Space-Fernie/system_test_board/README.md

# system_test_board
Test board for the Arietta G25 system
