Space-Fernie/system_test_board/Battery bracket/assembly.SLDASM

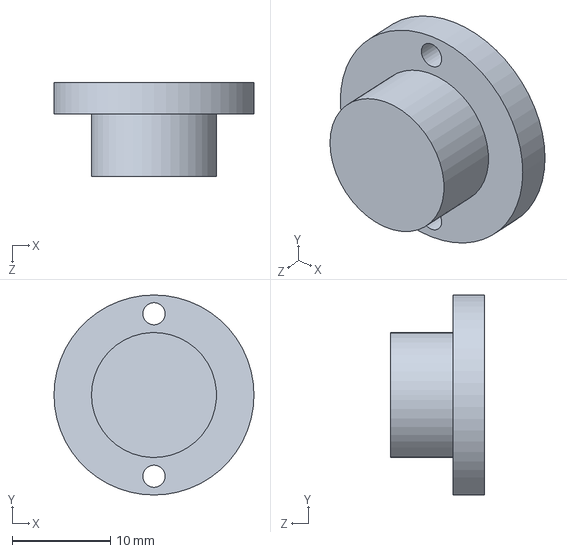
[picture p1: CAD file, 2017-11-16]
Battery bracket/assembly.SLDASM
20.3 x 20.3 x 9.53 mm
