Space-Fernie/system_test_board/Battery bracket/gen2/bracket_half_bottom.SLDPRT

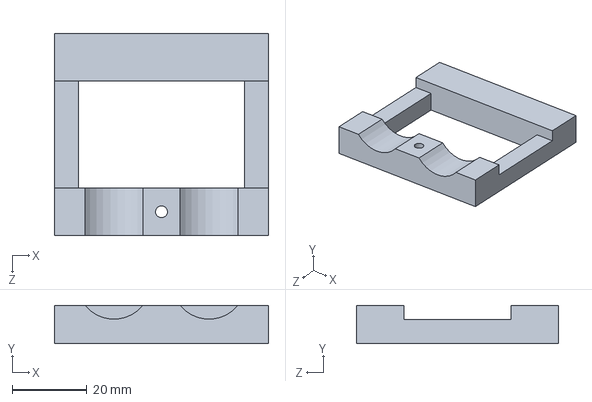
[picture p2: CAD file, 2017-09-18]
Battery bracket/gen2/bracket_half_bottom.SLDPRT
57.1 x 10.2 x 54.0 mm
