Space-Fernie/system_test_board/Test_board/Test_board.FCStd

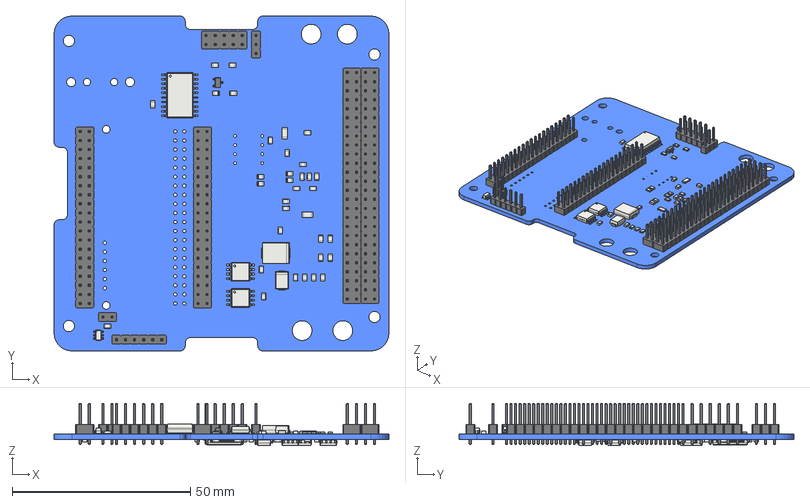
[picture p3: CAD file, 2017-12-14]
Test_board/Test_board.FCStd
94.0 x 94.0 x 11.9 mm
Pcb
Pin_Header_Straight_2x26_Pitch254mm_
Pin_Header_Straight_2x26_Pitch254mm_001
C_0805_
C_0805_001
C_0805_002
C_0805_003
C_0805_004
C_0805_005
C_0805_006
C_0805_007
C_0805_008
C_0805_009
C_0805_010
C_0805_011
C_0805_012
C_0805_013
C_0805_014
C_0805_015
C_0805_016
C_0805_017
C_0805_018
C_0805_019
C_0805_020
C_0805_021
C_0805_022
D_SMB_
D_SMC_
Pin_Header_Straight_2x05_Pitch254mm_
Pin_Header_Straight_1x03_Pitch254mm_
Pin_Header_Straight_2x20_Pitch254mm_
Pin_Header_Straight_1x06_Pitch254mm_
Pin_Header_Straight_2x20_Pitch254mm_001
Pin_Header_Straight_1x02_Pitch254mm_
SOT_23_
R_0805_
R_0805_001
R_0805_002
R_0805_003
R_0805_004
R_0805_005
R_0805_006
R_1206_
R_1206_001
R_0805_007
R_0805_008
R_0805_009
R_0805_010
R_0805_011
R_0805_012
R_0805_013
R_0805_014
R_0805_015
R_1206_002
R_0805_016
R_0805_017
SOIC-20W_7.5x12.8mm_Pitch1.27mm_
SOIJ-8_5.3x5.3mm_Pitch1.27mm_
SOIJ-8_5.3x5.3mm_Pitch1.27mm_001
LQFP-64_10x10mm_Pitch0.5mm_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
