Space-Fernie/system_test_board/Battery bracket/cell.SLDPRT

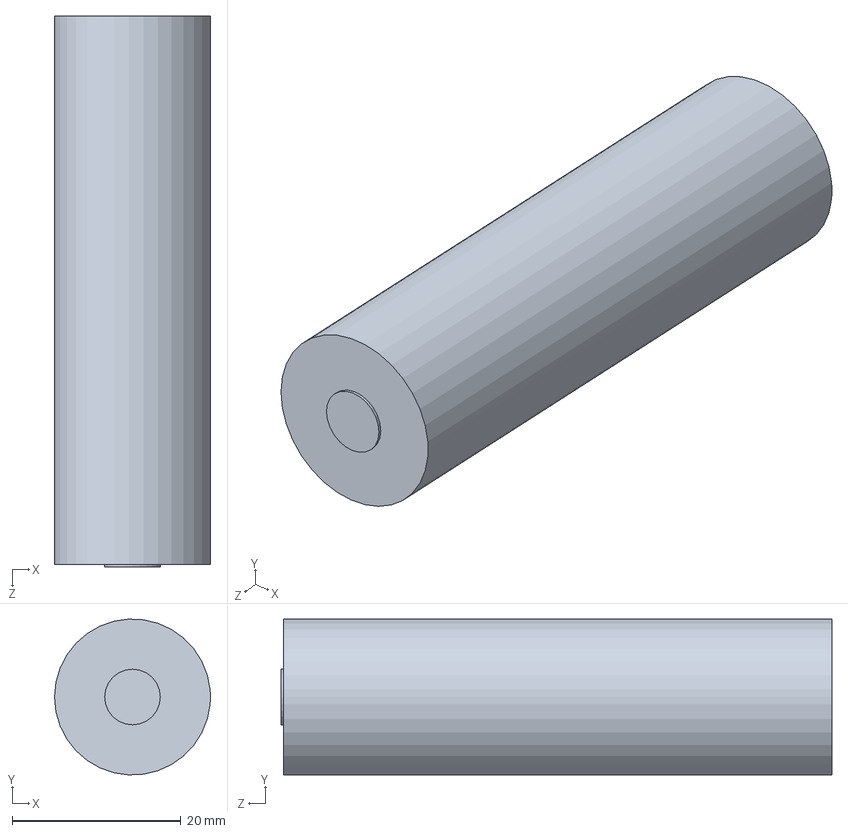
[picture p4: CAD file, 2017-09-18]
Battery bracket/cell.SLDPRT
18.5 x 18.5 x 65.3 mm
