Space-Fernie/system_test_board/Battery bracket/gen1/bracket.SLDASM

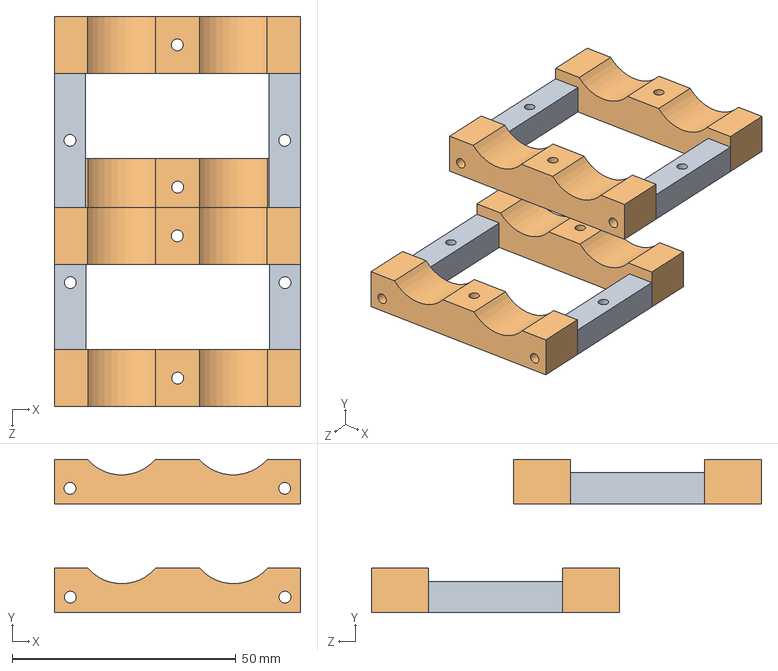
[picture p5: CAD file, 2017-09-18, an earlier design]
Battery bracket/gen1/bracket.SLDASM
55.1 x 34.3 x 87.2 mm
truss x 4
clamp x 4
