Space-Fernie/system_test_board/Battery bracket/gen1/bracket_half_top.SLDASM

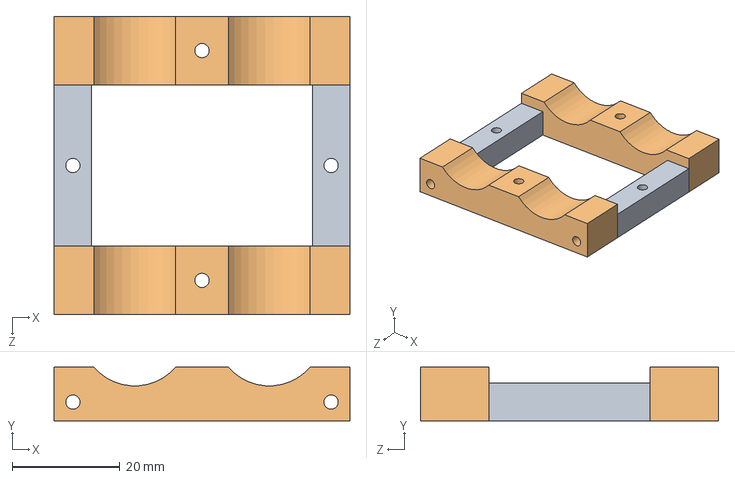
[picture p6: CAD file, 2017-09-18, an earlier design]
Battery bracket/gen1/bracket_half_top.SLDASM
55.0 x 10.0 x 55.4 mm
truss x 2
clamp x 2
