Space-Fernie/system_test_board/Battery bracket/gen1/clamp.SLDPRT

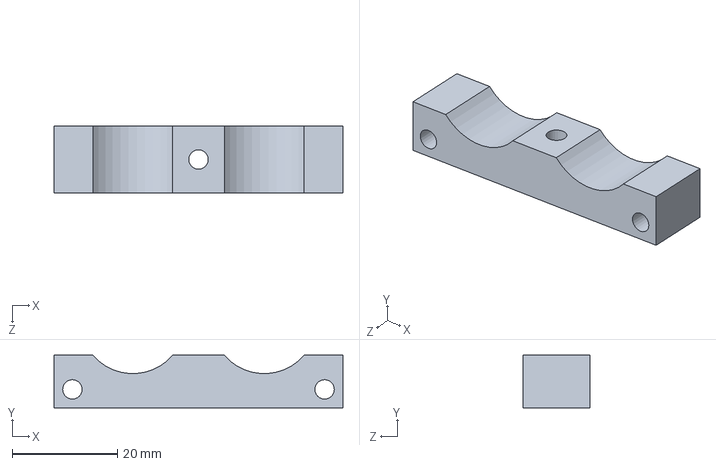
[picture p8: CAD file, 2017-09-18, an earlier design]
Battery bracket/gen1/clamp.SLDPRT
55.0 x 10.0 x 12.7 mm
