Space-Fernie/system_test_board/Battery bracket/gen1/truss.SLDPRT

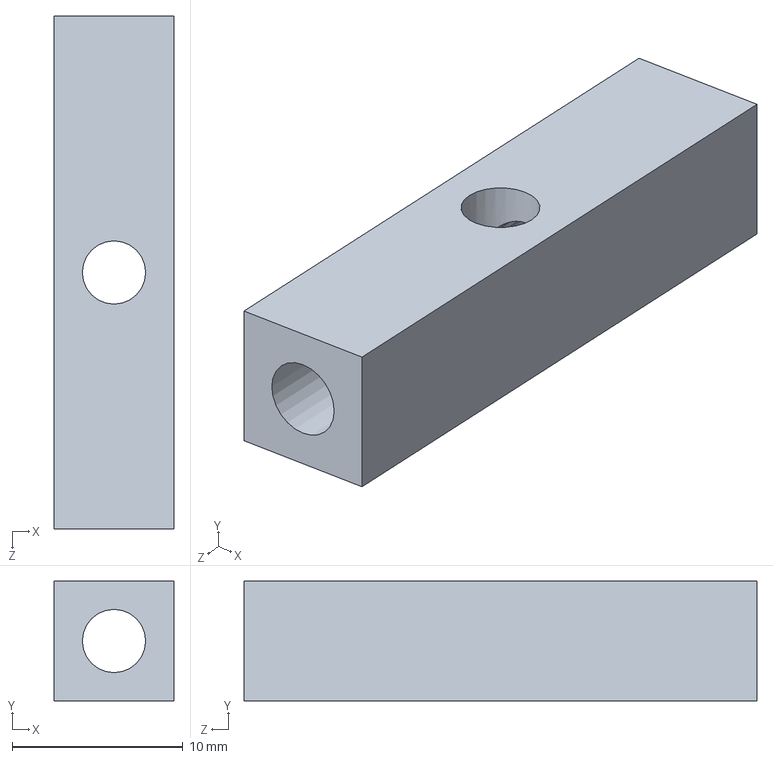
[picture p9: CAD file, 2017-09-18, an earlier design]
Battery bracket/gen1/truss.SLDPRT
7.00 x 7.00 x 30.0 mm
