Space-Fernie/system_test_board/Battery bracket/gen1/3dprintmodel.STL

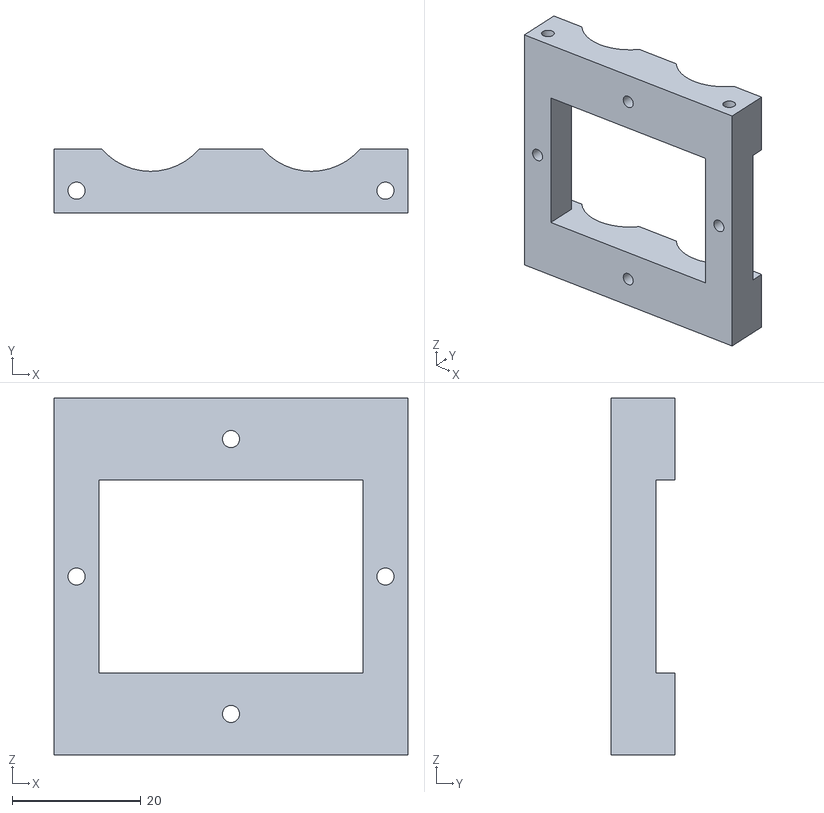
[picture p10: CAD file, 2017-09-18, an earlier design]
Battery bracket/gen1/3dprintmodel.STL
55.0 x 10.0 x 55.4
