Space-Fernie/system_test_board/(list of files, cad)

Other CAD files:
Barometer chamber/test_board model.SLDPRT
Barometer chamber/Barometer chamber.SLDPRT
Test_board/test_board model.wrl.sldprt
Barometer chamber/Barometer chamber.SLDDRW
