Space-Fernie/system_test_board/Documentation/Test Board Spreadsheets.xlsx

Sheet: I2C Addresses
Address | Device | Designator | All available addresses
1110110 | BMP280 |  | 1110110, 1110111
1110111 | BMP280 |  | 1110110, 1110111
1001000 | DS1624 |  | 1001000, 1001001, 1001010, 1001011, 1001100, 1001101, 1001110, 1001111
1001001 | DS1624 |  | 1001000, 1001001, 1001010, 1001011, 1001100, 1001101, 1001110, 1001111
1000000 | INA219 |  | INA219 Sheet
1000001 | INA219 |  | INA219 Sheet
1000100 | INA219 |  | INA219 Sheet
1000101 | INA219 |  | INA219 Sheet
1101000 | DS3232 |  | 1101000

Sheet: INA219 Sheet
A1 | A0 | ADDRESS |  | Rshunt CALCULATIONS AND IC PROGRAMMING
GND | GND | 1000000 | https://docs.google.com/a/spaceconcordia.ca/spreadsheets/d/1U1xCq4XOht2BvLV0Nj3WVBj3vr-w16HBE9G5WGe6P6k/edit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 | <- Power Budget
GND | VS+ | 1000001 | Components |  | Current | Max Vshunt: | 0.05
GND | SDA | 1000010 | Battery Heaters (4) |  | 0.5862 | Rshunt | 0.02319
GND | SCL | 1000011 | Thermistors |  | 0.001
VS+ | GND | 1000100 | OBC |  | 0.0634
VS+ | VS+ | 1000101 | Power Sensors (4) |  | 0.0028 | Total Cal: | 26843 | =0x68DB
VS+ | SDA | 1000110 | RTC |  | 0.0002 | 3V3 Cal: | 48240 | =0xBC70
VS+ | SCL | 1000111 | Pressure Sensors(2) |  | 5.4e-06
SDA | GND | 1001000 | Temp Sensors (2) |  | 0.0025
SDA | VS+ | 1001001 | Comparator |  | 0.0004
SDA | SDA | 1001010 | USB2 Max Current (3) |  | 1.5
SDA | SCL | 1001011 |  | Total Current: | 2.1565054
SCL | GND | 1001100 |  | Power Current_LSB | 6.581132202e-05
SCL | VS+ | 1001101
SCL | SDA | 1001110 |  | 3V3 Max I: | 1.2
SCL | SCL | 1001111 |  | 3V3 Current_LSB | 3.662109375e-05
