Space-Fernie/system_test_board/(threads)

Thread 1 (2017-09-18):

No mounting holes

SpaceFernie, 2017-09-18:
There are no mounting holes on the board. Add some.

SpaceFernie, 2017-11-03:
Fixed with the implementation of a cubesat pcb template

Closed 2017-11-03.

Thread 2 (2017-09-18):

Not enough power vias

SpaceFernie, 2017-09-18:
There is only one via leading from the 3V3 power sensor shunt resistor to the 3V3 plane (the entrance of the 3V3 converter to the power plane). There needs to be more stitching for the line.

SpaceFernie, 2017-11-03:
Complete board redesign, closing issue

Closed 2017-11-03.

Thread 3 (2017-09-18):

Charge pump

SpaceFernie, 2017-09-18:
The board needs a charge pump to improve operation in an irradiated environment.

SpaceFernie, 2017-11-03:
Not sure if charge pump is the good term

SpaceFernie, 2017-11-03:
Will not be implemented. Issue closed

Closed 2017-11-03.

Thread 5 (2017-09-19):

Packages

SpaceFernie, 2017-09-19:
QFN is a terrible package to use when not necessary, simply because it is a pain to assemble a board with. Try to replace all the QFN packages with something like QFP.
Also, try to get larger ICs in general.

SpaceFernie, 2017-11-10:
No QFNs on V2.1

Closed 2017-11-10.

Thread 6 (2017-09-19):

Banana jacks don't fit in hole

SpaceFernie, 2017-09-19:
The banana jacks cannot fit in their holes. The holes are slightly too small. Increase diameter of holes by 0.8 mm.

SpaceFernie, 2017-11-10:
Fixed hole dimension

Closed 2017-11-10.

Thread 8 (2017-09-20):

Replace MCUs

Space-Fernie, 2017-09-20:
Remove PIC24. NASA experiments show that they are not re programmable after enough radiation. Arm will remain, but research should be conducted to determine the best core and manufacturer.

Space-Fernie, 2017-10-09:
Both MCUs removed, STM32F303RE added.

Closed 2017-10-09.

Thread 11 (2017-09-22):

Add ACDS Sensors

SpaceFernie, 2017-09-22:
Add a magnetometer and gyro, and potentially a 9DoF unit. Look into proper installation of units.

SpaceFernie, 2017-11-03:
Will not implement

Closed 2017-11-03.

Thread 12 (2017-09-22):

Add input protection

SpaceFernie, 2017-09-22:
Input protection on banana jacks and battery so that idiots don't destroy everything by applying reverse polarity.

SpaceFernie, 2017-11-07:
Won't be implemented, not enough time.

Closed 2017-11-07.

Thread 9 (2017-09-22):

Capacitors Blocking Battery Bracket

SpaceFernie, 2017-09-22:
Capacitors C30 to C33 are in the way.

SpaceFernie, 2017-11-03:
No batteries to be included on main board in new version

Closed 2017-11-03.

Thread 15 (2017-11-03):

Power bus stability

SpaceFernie, 2017-11-03:
Check rippling on bus, add smoothing of necessary

SpaceFernie, 2017-11-07:
Used manufacturer design

Closed 2017-11-07.
