Space-Fernie/system_test_board/test_board.pdf

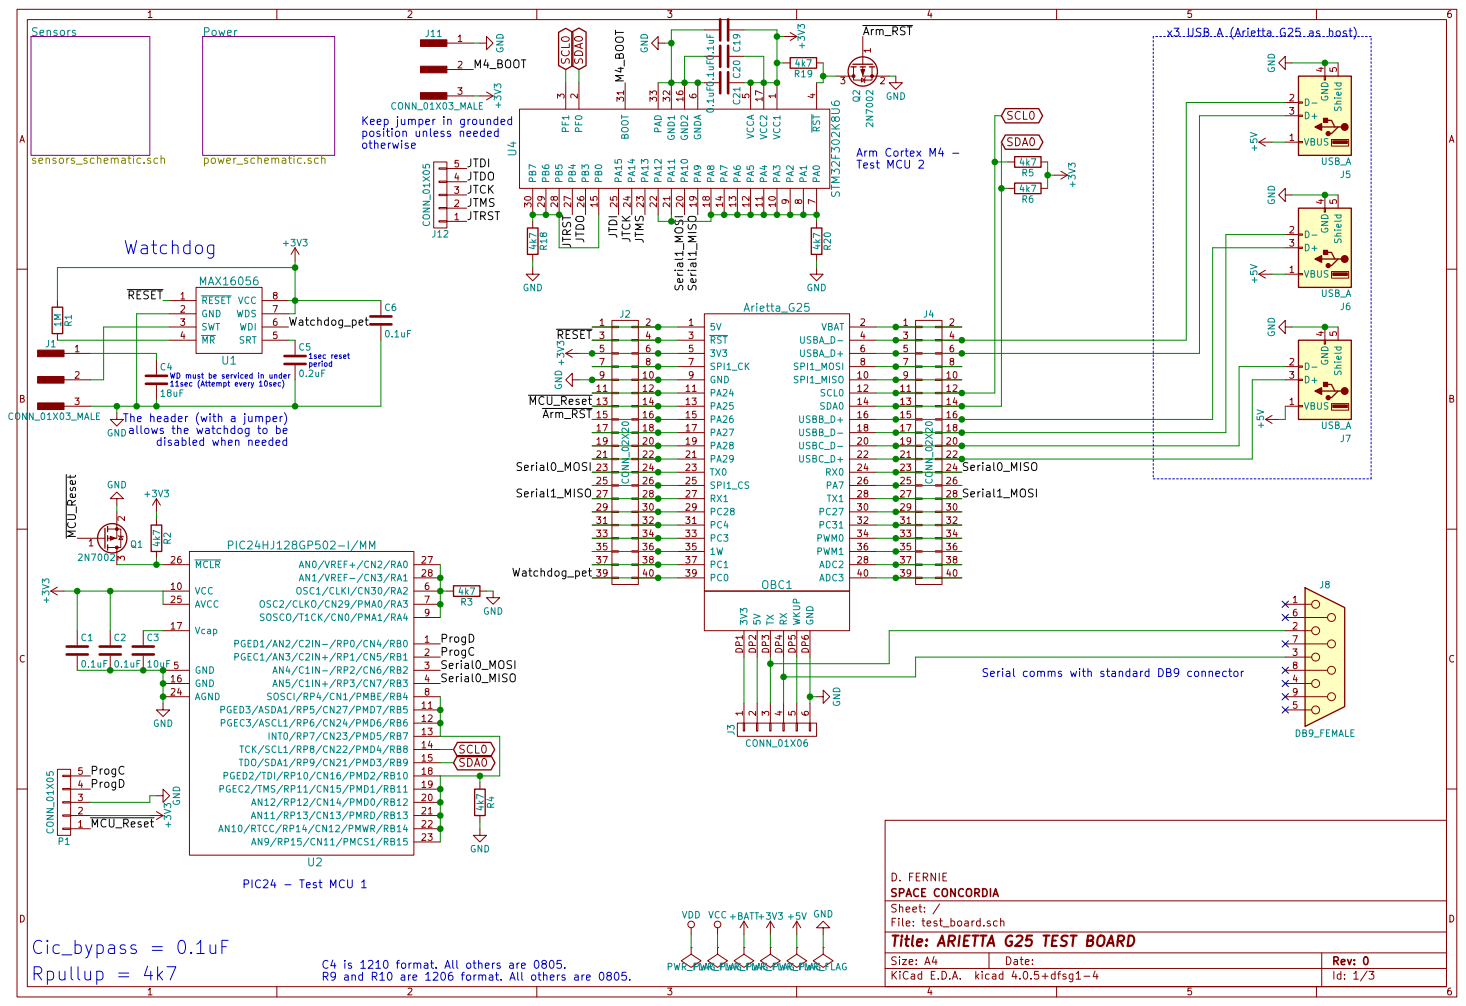
[picture p11: page 1]

x3 USB A (Arietta G25 as host)

Keep jumper in grounded
position unless needed otherwise

The header (with a jumper)
allows the watchdog to be
disabled when needed

Serial comms with standard DB9 connector

D. FERNIE
File: test_board.sch Sheet: / SPACE CONCORDIA

Id: 1/3 Title: ARIETTA G25 TEST BOARD

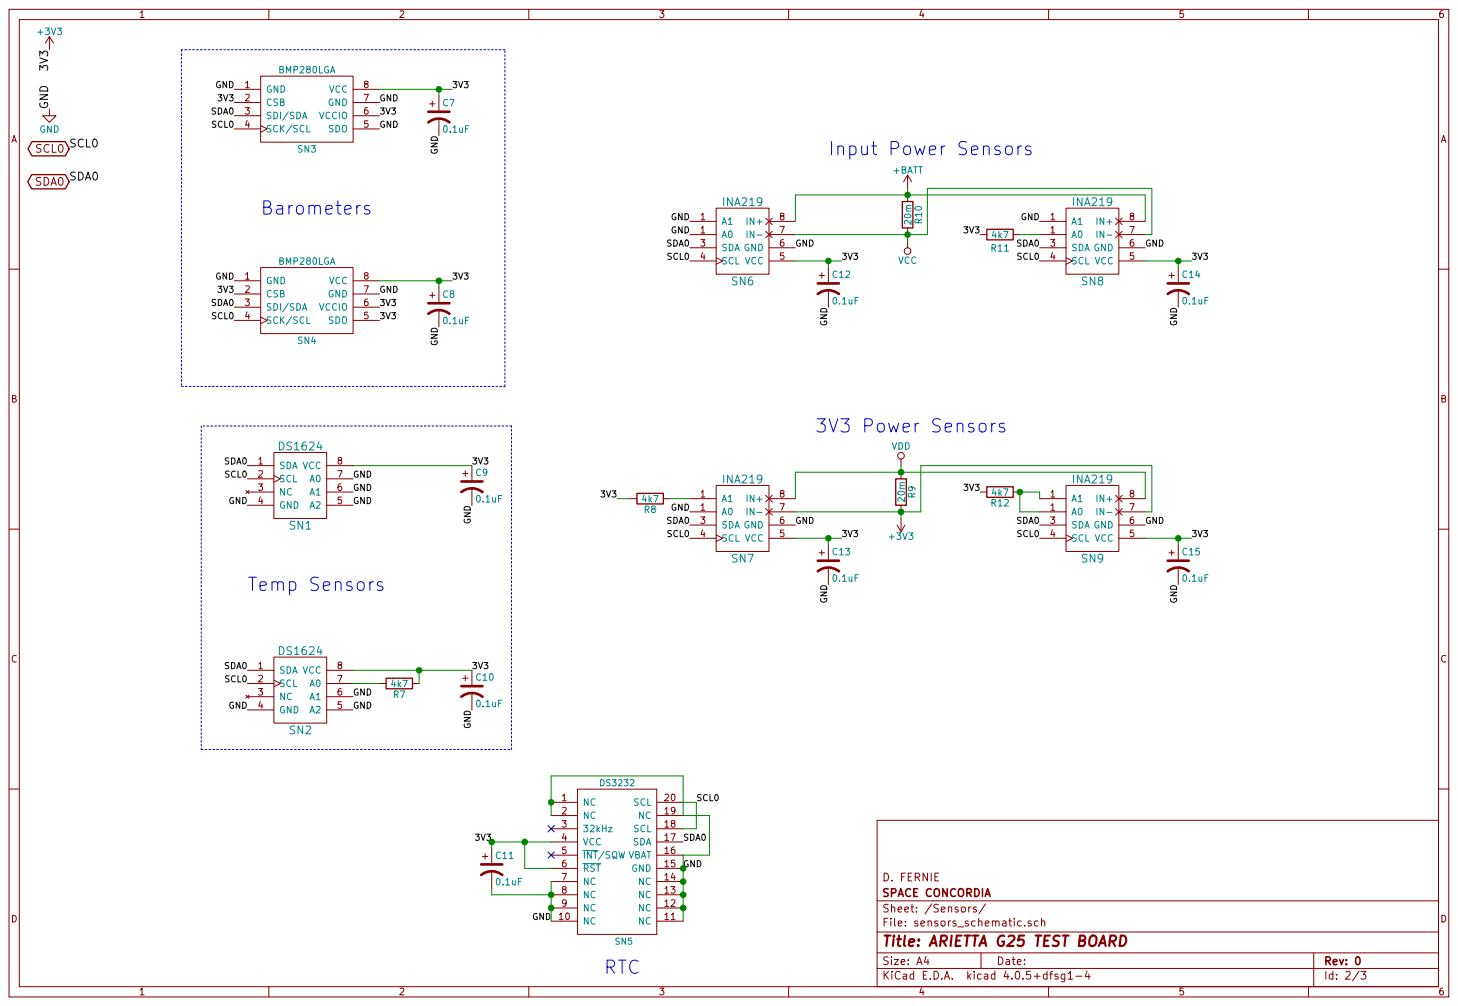
[picture p12: page 2]

D. FERNIE
File: sensors_schematic.sch Sheet: /Sensors/ SPACE CONCORDIA

Id: 2/3 Title: ARIETTA G25 TEST BOARD

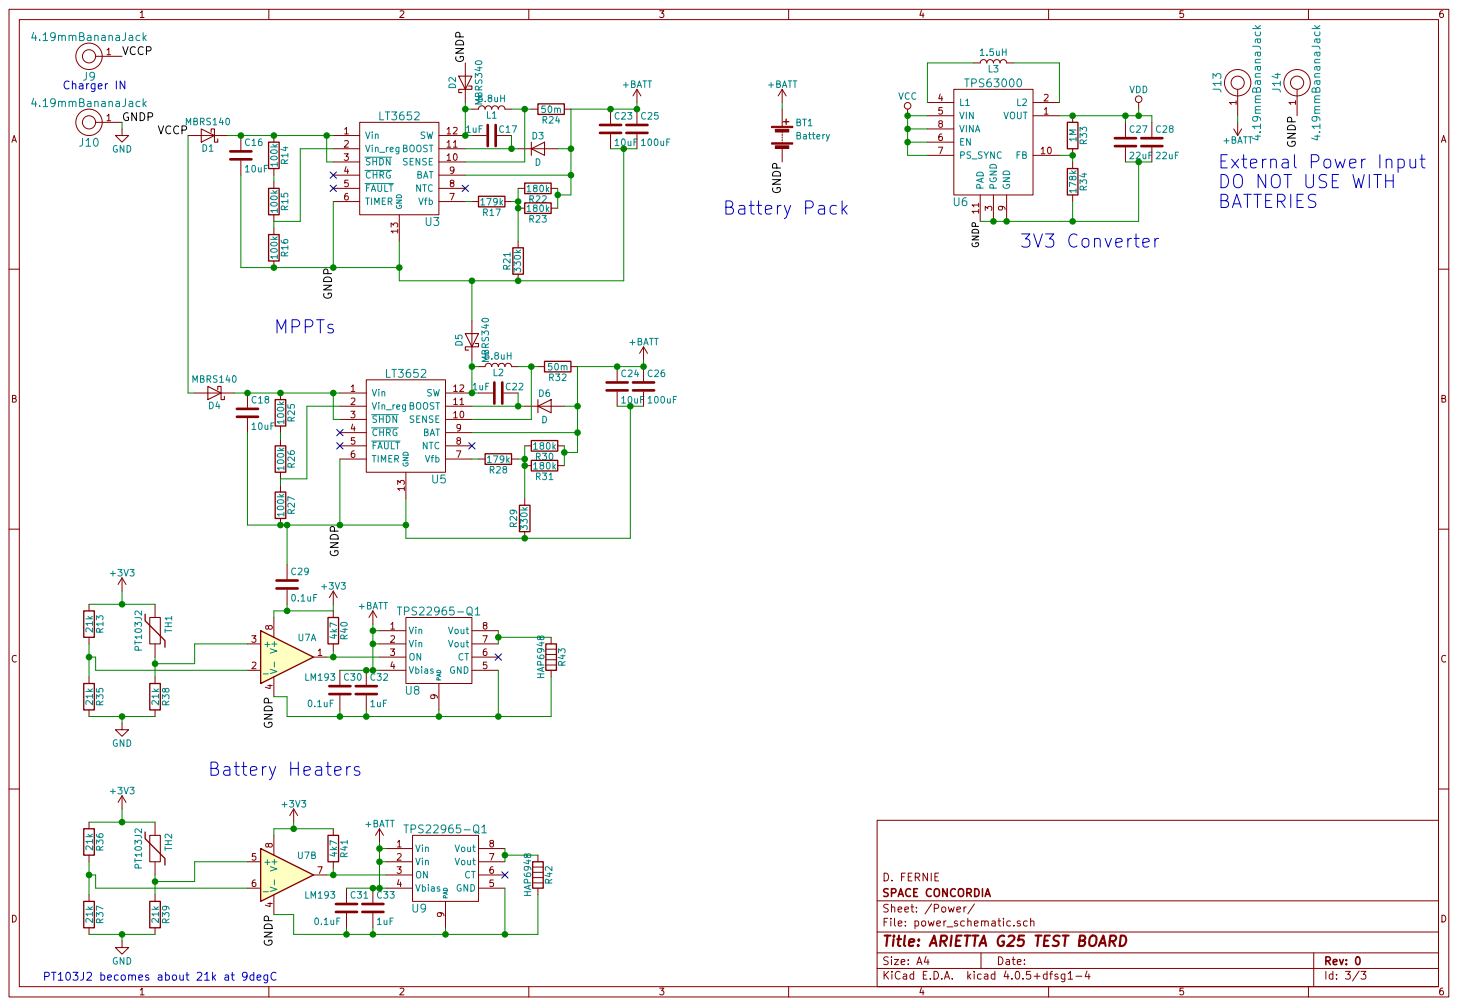
[picture p13: page 3]

External Power Input
DO NOT USE WITH

D. FERNIE
File: power_schematic.sch Sheet: /Power/ SPACE CONCORDIA

Id: 3/3 Title: ARIETTA G25 TEST BOARD
