Space-Fernie/system_test_board/Documentation/arietta_footprint.pdf

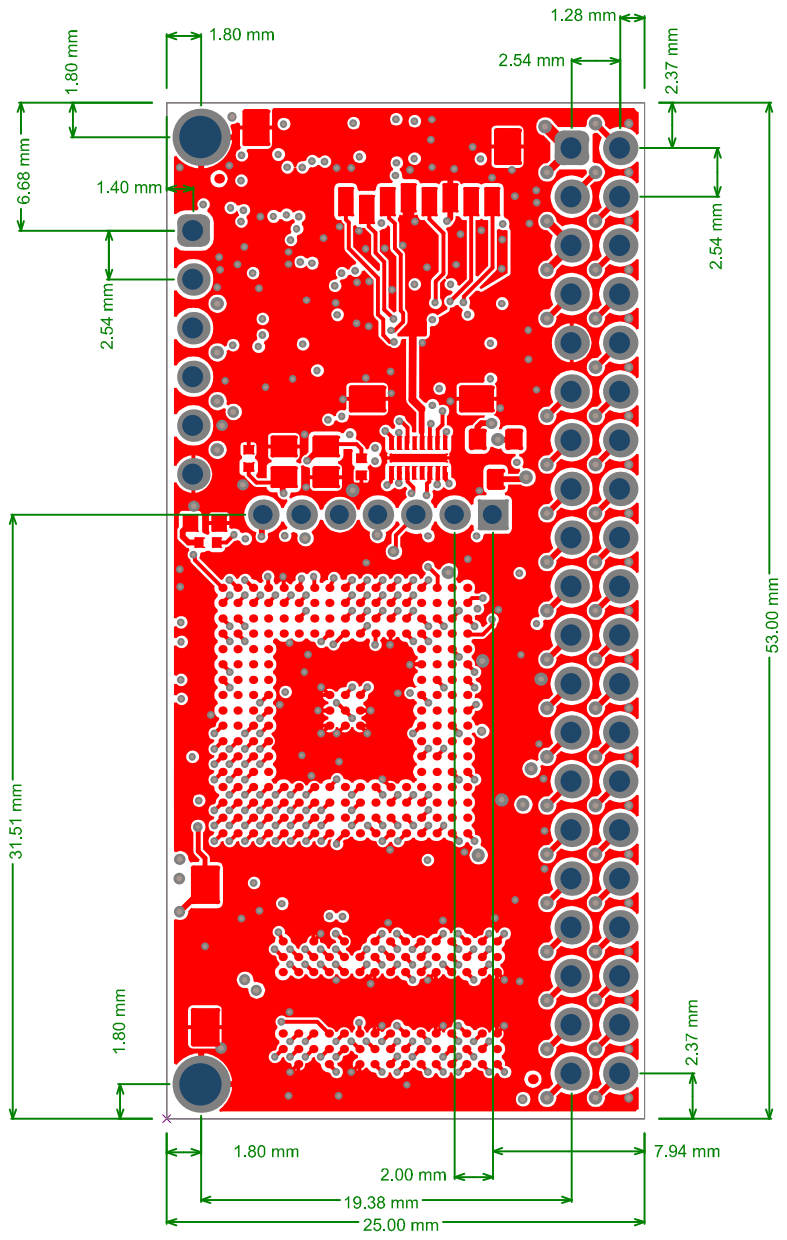
[picture p14: page 1]
