Space-Fernie/system_test_board/Battery bracket/gen1/old battery bracket.PDF

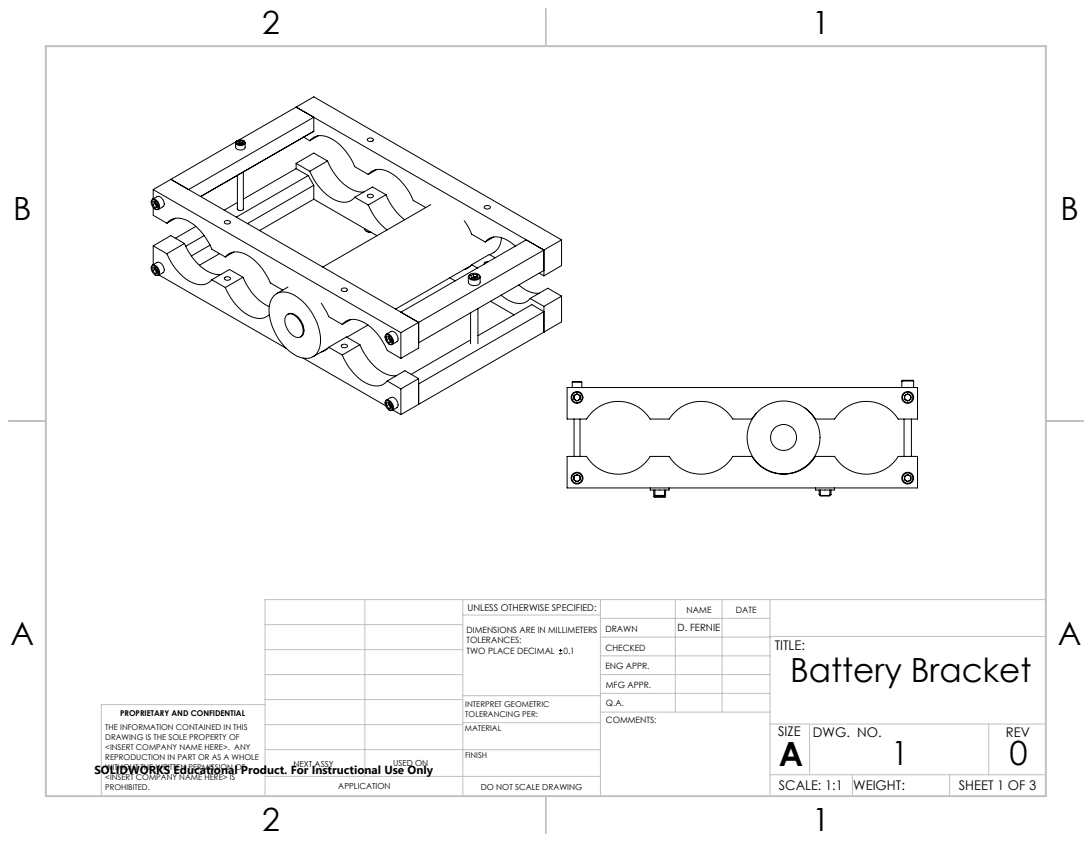
[picture p15: page 1]
SHEET 1 OF 3; SCALE: 1:1; WEIGHT:; DWG. NO.; REV; NEXT ASSY; USED ON

UNLESS OTHERWISE SPECIFIED: | | NAME | DATE
DIMENSIONS ARE IN MILLIMETERS TOLERANCES: TWO PLACE DECIMAL 0.1 | DRAWN | D. FERNIE

CHECKED | | | TITLE: Battery Bracket

ENG APPR.
MFG APPR.

INTERPRET GEOMETRIC TOLERANCING PER: | Q.A.

PROPRIETARY AND CONFIDENTIAL
THE INFORMATION CONTAINED IN THIS
DRAWING IS THE SOLE PROPERTY OF
<INSERT COMPANY NAME HERE>. ANY
REPRODUCTION IN PART OR AS A WHOLE
SOLIDWORKS Educational Product. For Instructional Use Only
WITHOUT THE WRITTEN PERMISSION OF
<INSERT COMPANY NAME HERE> IS
PROHIBITED.

DO NOT SCALE DRAWING

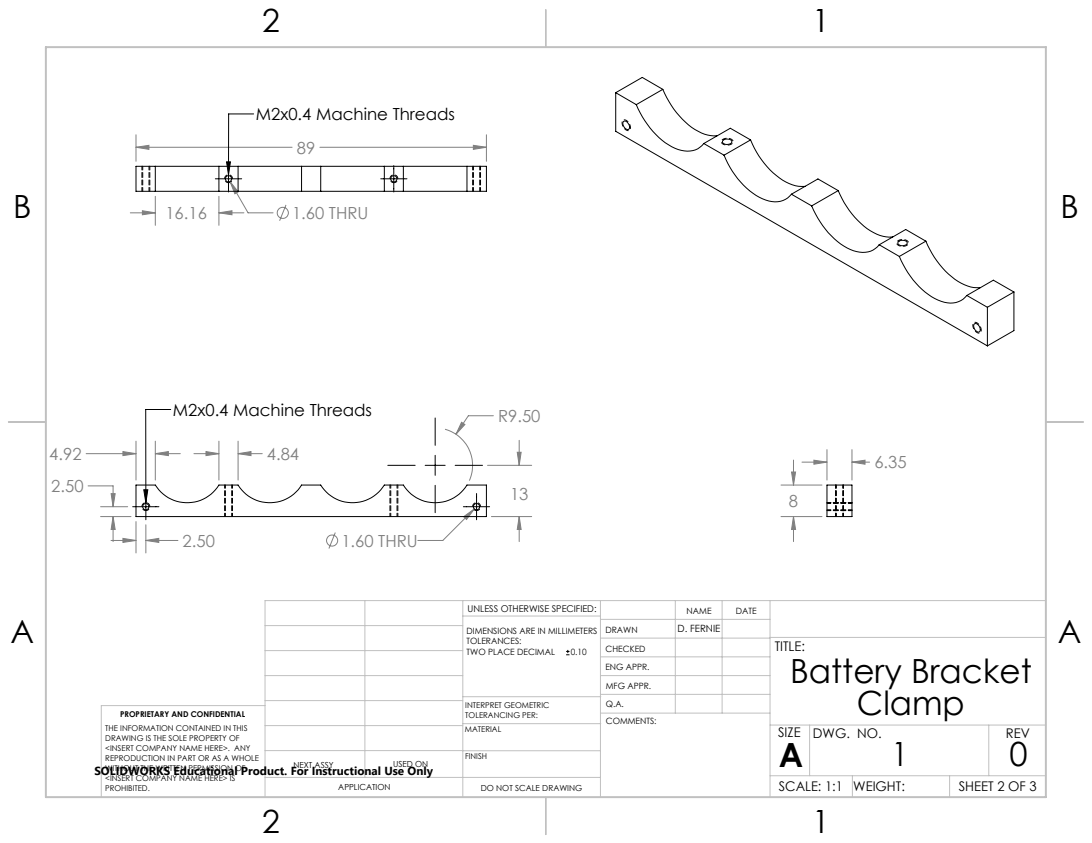
[picture p16: page 2]
1.60 THRU; M2x0.4 Machine Threads; SCALE: 1:1; WEIGHT:; DWG. NO.; REV; NEXT ASSY; USED ON

UNLESS OTHERWISE SPECIFIED: | | NAME | DATE
DIMENSIONS ARE IN MILLIMETERS TOLERANCES: TWO PLACE DECIMAL 0.10 | DRAWN | D. FERNIE

CHECKED | | | TITLE: Battery Bracket Clamp

ENG APPR.
MFG APPR.

INTERPRET GEOMETRIC TOLERANCING PER: | Q.A.

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

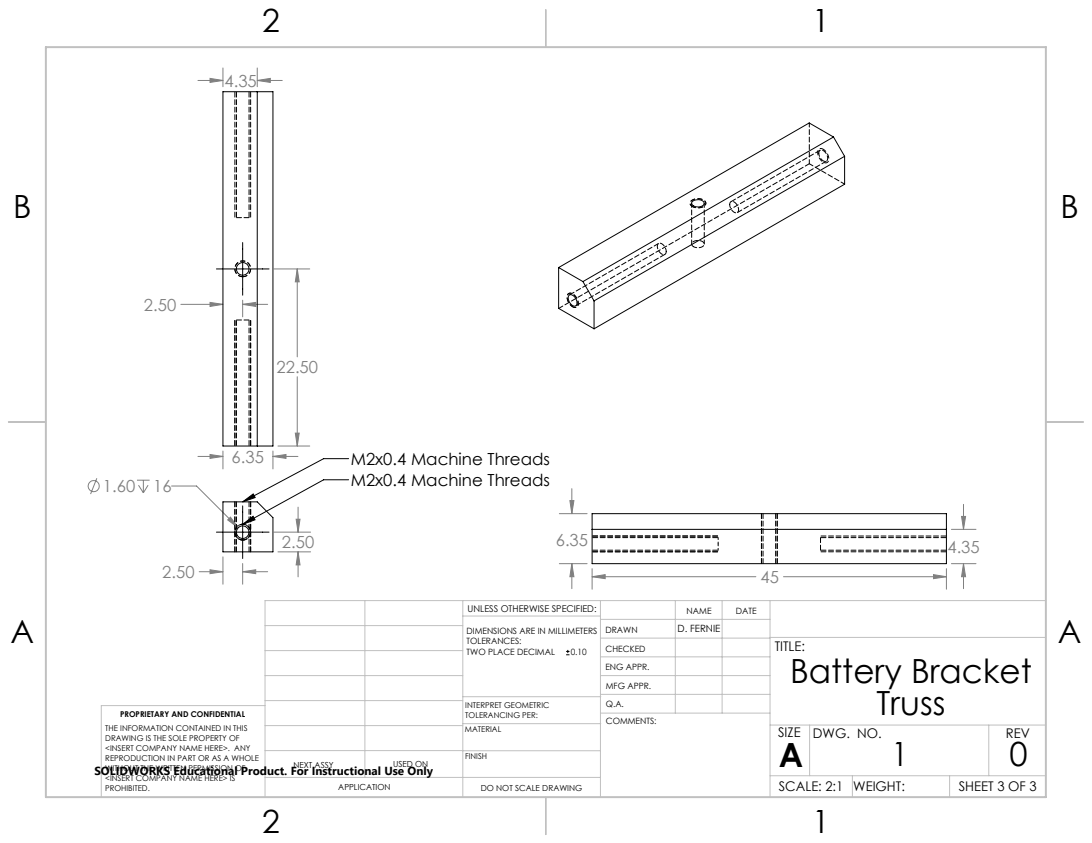
[picture p17: page 3]
M2x0.4 Machine Threads M2x0.4 Machine Threads; SCALE: 2:1; WEIGHT:; DWG. NO.; REV; NEXT ASSY; USED ON

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

CHECKED | | | TITLE: Battery Bracket Truss

ENG APPR.
MFG APPR.

INTERPRET GEOMETRIC TOLERANCING PER: | Q.A.

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
