Space-Fernie/system_test_board/Test_board/Test_board.kicad_pcb

## KiCad design Test_board/Test_board.kicad_pcb (2017-11-10)

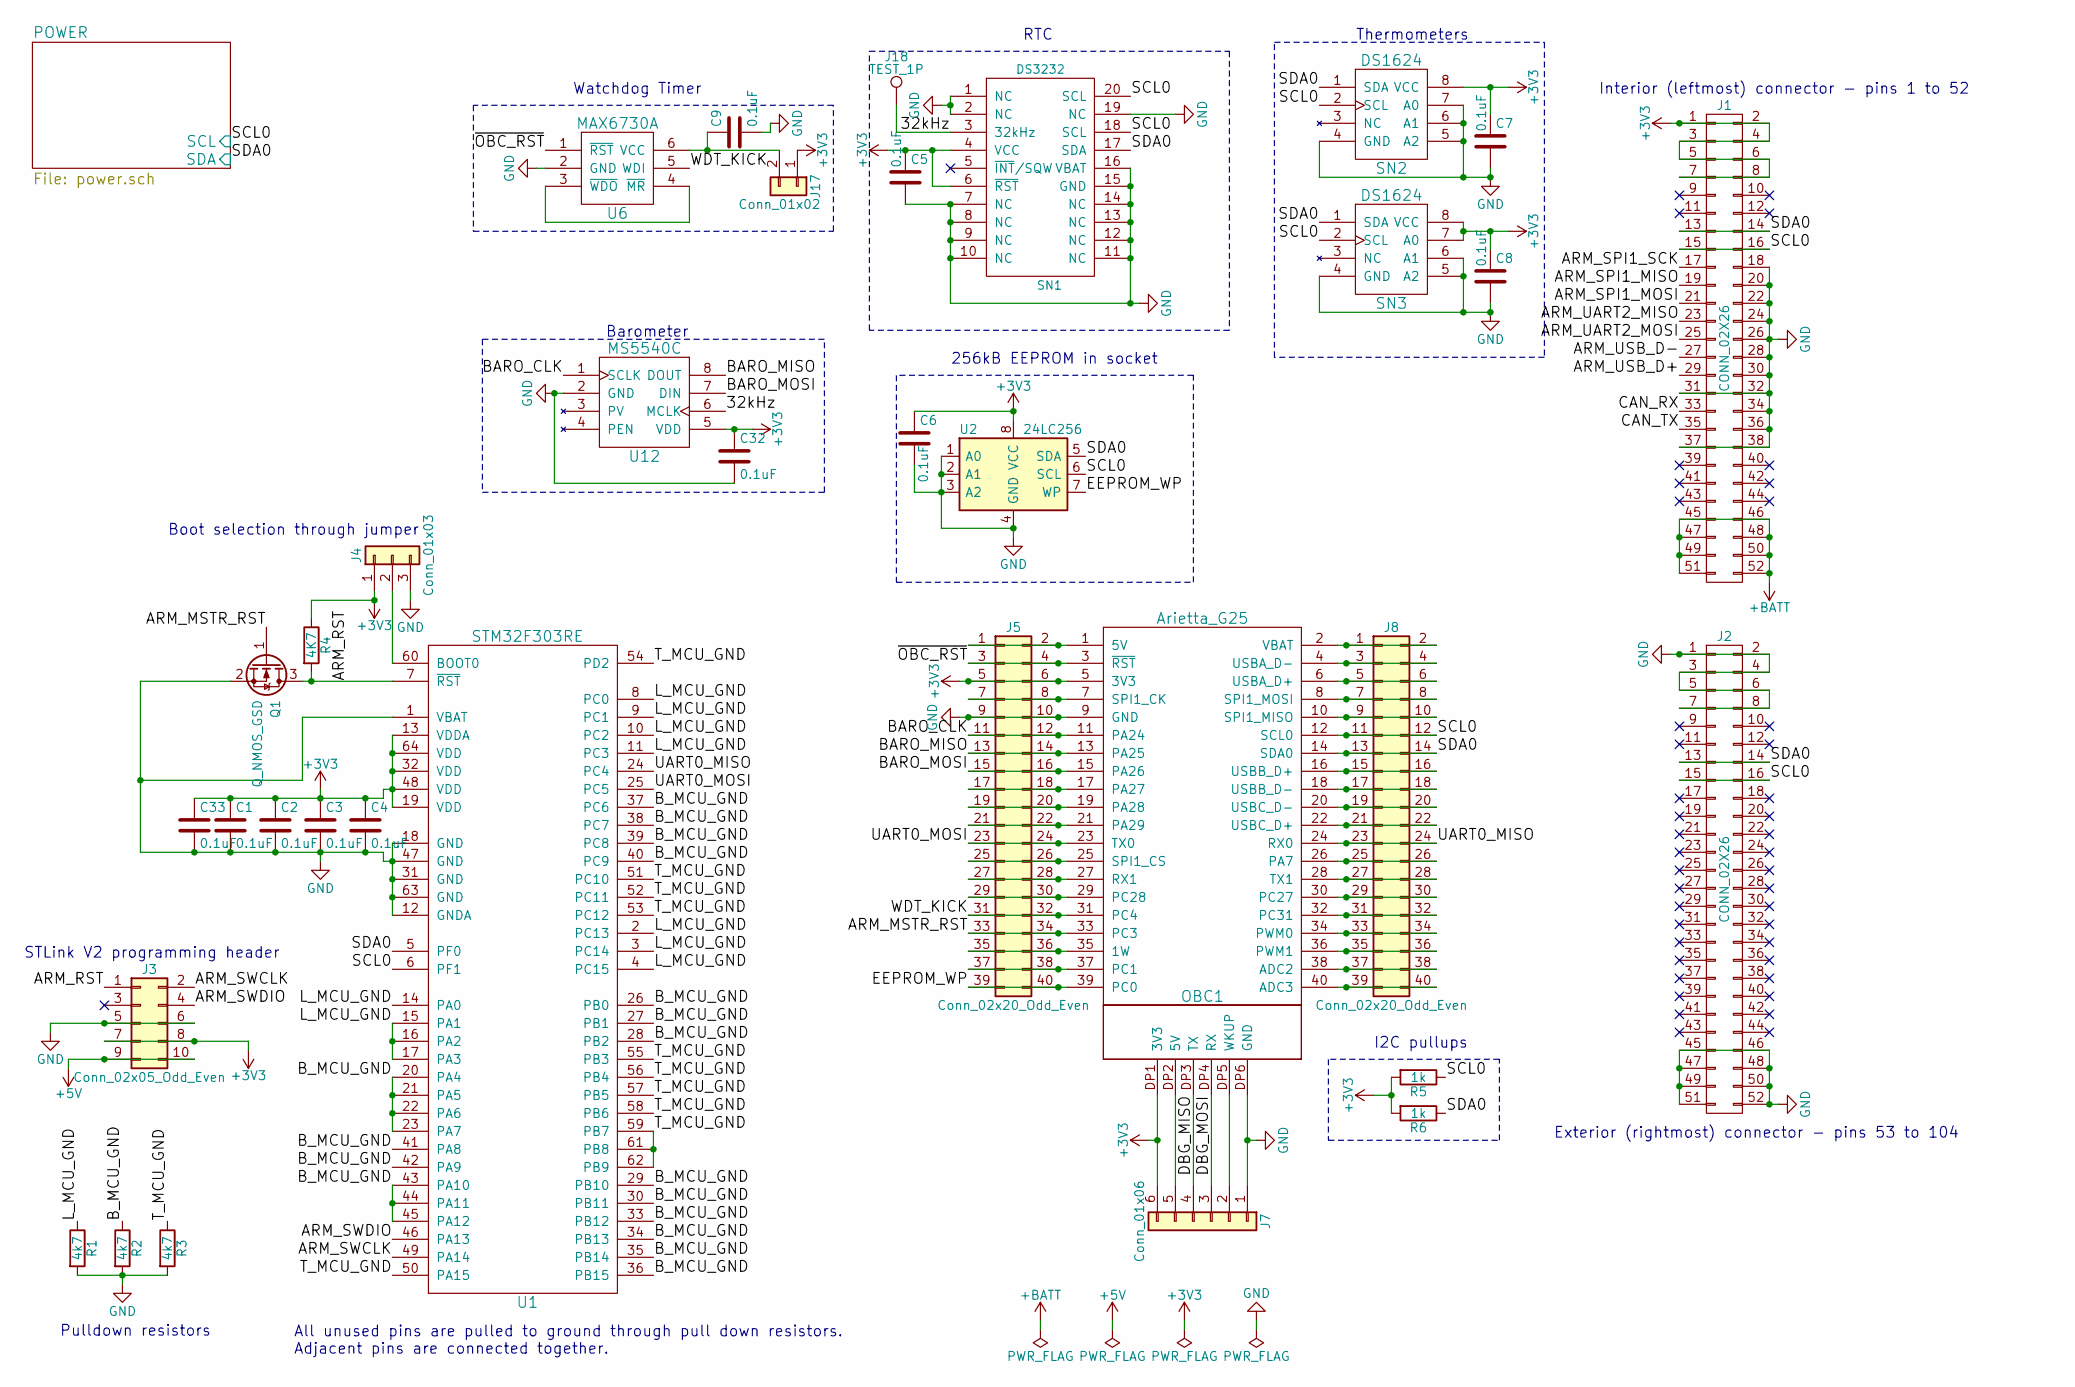
[picture p18: schematic test_board.sch, ARIETTA TEST BOARD]

Parts:
C1, C2, C3, C4, C5, C6, C7, C8, C9, C32, C33: 0.1uF; C_0805_HandSoldering
J1, J2: CONN_02X26; Pin_Header_Straight_2x26_Pitch2.54mm
J3: Conn_02x05_Odd_Even; Pin_Header_Straight_2x05_Pitch2.54mm
J4: Conn_01x03; Pin_Header_Straight_1x03_Pitch2.54mm
J5, J8: Conn_02x20_Odd_Even; Pin_Header_Straight_2x20_Pitch2.54mm
J7: Conn_01x06; Pin_Header_Straight_1x06_Pitch2.54mm
J17: Conn_01x02; Pin_Header_Straight_1x02_Pitch2.54mm
J18: TEST_1P; Measurement_Point_Round-SMD-Pad_Big
OBC1: Arietta_G25
Q1: Q_NMOS_GSD; SOT-23_Handsoldering
R1, R2, R3: 4k7; R_0805_HandSoldering
R4: 4K7; R_0805_HandSoldering
R5, R6: 1k; R_0805_HandSoldering
SN1: DS3232; SOIC-20W_7.5x12.8mm_Pitch1.27mm
SN2, SN3: DS1624; SOIJ-8_5.3x5.3mm_Pitch1.27mm
U1: STM32F303RE; LQFP-64_10x10mm_Pitch0.5mm
U2: 24LC256; DIP-8_W7.62mm_Socket
U6: MAX6730A; SOT-23-6_Handsoldering
U12: MS5540C

Connections:
+3V3: C1.1, C2.1, C3.1, C4.1, C5.1, C6.1, C7.1, C8.1, C32.1, C33.1, J1.1, J1.2, J1.3, J1.4, J1.5, J1.6, J1.7, J1.8, J3.7, J3.8, J4.1, J5.5, J5.6, J7.6, J17.1, OBC1.5 (3V3), OBC1.DP1 (3V3), R4.1, R5.2, R6.2, SN1.4 (VCC), SN1.6 (~RST), SN2.8 (VCC), SN3.7 (A0), SN3.8 (VCC), U1.13 (VDDA), U1.19 (VDD), U1.32 (VDD), U1.48 (VDD), U1.64 (VDD), U2.8 (VCC), U12.5 (VDD); also elsewhere on the board
+5V: J3.9, J3.10
+BATT: J1.45, J1.46, J1.47, J1.48, J1.49, J1.50, J1.51, J1.52; also elsewhere on the board
/32kHz: J18.1, SN1.3 (32kHz), U12.6 (MCLK)
/ARM_MSTR_RST: J5.33, J5.34, OBC1.33 (PC3), Q1.1 (G)
/ARM_RST: J3.1, Q1.3 (D), R4.2, U1.7 (~RST)
/ARM_SPI1_MISO: J1.19
/ARM_SPI1_MOSI: J1.21
/ARM_SPI1_SCK: J1.17
/ARM_SWCLK: J3.2, U1.49 (PA14)
/ARM_SWDIO: J3.4, U1.46 (PA13)
/ARM_UART2_MISO: J1.23
/ARM_UART2_MOSI: J1.25
/ARM_USB_D+: J1.29
/ARM_USB_D-: J1.27
/BARO_CLK: J5.11, J5.12, OBC1.11 (PA24), U12.1 (SCLK)
/BARO_MISO: J5.13, J5.14, OBC1.13 (PA25), U12.8 (DOUT)
/BARO_MOSI: J5.15, J5.16, OBC1.15 (PA26), U12.7 (DIN)
/B_MCU_GND: R2.1, U1.20 (PA4), U1.21 (PA5), U1.22 (PA6), U1.23 (PA7), U1.26 (PB0), U1.27 (PB1), U1.28 (PB2), U1.29 (PB10), U1.30 (PB11), U1.33 (PB12), U1.34 (PB13), U1.35 (PB14), U1.36 (PB15), U1.37 (PC6), U1.38 (PC7), U1.39 (PC8), U1.40 (PC9), U1.41 (PA8), U1.42 (PA9), U1.43 (PA10), U1.44 (PA11), U1.45 (PA12)
/CAN_RX: J1.33
/CAN_TX: J1.35
/DBG_MISO: J7.4, OBC1.DP3 (TX)
/DBG_MOSI: J7.3, OBC1.DP4 (RX)
/EEPROM_WP: J5.39, J5.40, OBC1.39 (PC0), U2.7 (WP)
/L_MCU_GND: R1.1, U1.2 (PC13), U1.3 (PC14), U1.4 (PC15), U1.8 (PC0), U1.9 (PC1), U1.10 (PC2), U1.11 (PC3), U1.14 (PA0), U1.15 (PA1), U1.16 (PA2), U1.17 (PA3)
/SCL0: J1.15, J1.16, J2.15, J2.16, J8.11, J8.12, OBC1.12 (SCL0), R5.1, SN1.18 (SCL), SN1.20 (SCL), SN2.2 (SCL), SN3.2 (SCL), U1.6 (PF1), U2.6 (SCL); also elsewhere on the board
/SDA0: J1.13, J1.14, J2.13, J2.14, J8.13, J8.14, OBC1.14 (SDA0), R6.1, SN1.17 (SDA), SN2.1 (SDA), SN3.1 (SDA), U1.5 (PF0), U2.5 (SDA); also elsewhere on the board
/T_MCU_GND: R3.1, U1.50 (PA15), U1.51 (PC10), U1.52 (PC11), U1.53 (PC12), U1.54 (PD2), U1.55 (PB3), U1.56 (PB4), U1.57 (PB5), U1.58 (PB6), U1.59 (PB7), U1.61 (PB8), U1.62 (PB9)
/UART0_MISO: J8.23, J8.24, OBC1.24 (RX0), U1.24 (PC4)
/UART0_MOSI: J5.23, J5.24, OBC1.23 (TX0), U1.25 (PC5)
/WDT_KICK: J5.31, J5.32, OBC1.31 (PC4), U6.5 (WDI)
/~OBC_RST: J5.3, J5.4, OBC1.3 (~RST), U6.1 (~RST)
GND: C1.2, C2.2, C3.2, C4.2, C5.2, C6.2, C7.2, C8.2, C9.2, C32.2, C33.2, J1.18, J1.20, J1.22, J1.24, J1.26, J1.28, J1.30, J1.31, J1.32, J1.34, J1.36, J1.37, J1.38, J2.1, J2.2, J2.3, J2.4, J2.5, J2.6, J2.7, J2.8, J2.45, J2.46, J2.47, J2.48, J2.49, J2.50, J2.51, J2.52, J3.5, J3.6, J4.3, J5.9, J5.10, J7.1, OBC1.9 (GND), OBC1.DP6 (GND), Q1.2 (S), R1.2, R2.2, R3.2, SN1.1 (NC), SN1.2 (NC), SN1.7 (NC), SN1.8 (NC), SN1.9 (NC), SN1.10 (NC), SN1.11 (NC), SN1.12 (NC), SN1.13 (NC), SN1.14 (NC), SN1.15 (GND), SN1.16 (VBAT), SN1.19 (NC), SN2.4 (GND), SN2.5 (A2), SN2.6 (A1), SN2.7 (A0), SN3.4 (GND), SN3.5 (A2), SN3.6 (A1), U1.1 (VBAT), U1.12 (GNDA), U1.18 (GND), U1.31 (GND), U1.47 (GND), U1.63 (GND), U2.1 (A0), U2.2 (A1), U2.3 (A2), U2.4 (GND), U6.2 (GND), U12.2 (GND); also elsewhere on the board
unnamed: C9.1, J17.2, U6.6 (VCC)
unnamed: J4.2, U1.60 (BOOT0)
unnamed: J5.1, J5.2, OBC1.1 (5V)
unnamed: J5.7, J5.8, OBC1.7 (SPI1_CK)
unnamed: J5.17, J5.18, OBC1.17 (PA27)
unnamed: J5.19, J5.20, OBC1.19 (PA28)
unnamed: J5.21, J5.22, OBC1.21 (PA29)
unnamed: J5.25, J5.26, OBC1.25 (SPI1_CS)
unnamed: J5.27, J5.28, OBC1.27 (RX1)
unnamed: J5.29, J5.30, OBC1.29 (PC28)
unnamed: J5.35, J5.36, OBC1.35 (1W)
unnamed: J5.37, J5.38, OBC1.37 (PC1)
unnamed: J7.2, OBC1.DP5 (WKUP)
unnamed: J7.5, OBC1.DP2 (5V)
unnamed: J8.1, J8.2, OBC1.2 (VBAT)
unnamed: J8.3, J8.4, OBC1.4 (USBA_D-)
unnamed: J8.5, J8.6, OBC1.6 (USBA_D+)
unnamed: J8.7, J8.8, OBC1.8 (SPI1_MOSI)
unnamed: J8.9, J8.10, OBC1.10 (SPI1_MISO)
unnamed: J8.15, J8.16, OBC1.16 (USBB_D+)
unnamed: J8.17, J8.18, OBC1.18 (USBB_D-)
unnamed: J8.19, J8.20, OBC1.20 (USBC_D-)
unnamed: J8.21, J8.22, OBC1.22 (USBC_D+)
unnamed: J8.25, J8.26, OBC1.26 (PA7)
unnamed: J8.27, J8.28, OBC1.28 (TX1)
unnamed: J8.29, J8.30, OBC1.30 (PC27)
unnamed: J8.31, J8.32, OBC1.32 (PC31)
unnamed: J8.33, J8.34, OBC1.34 (PWM0)
unnamed: J8.35, J8.36, OBC1.36 (PWM1)
unnamed: J8.37, J8.38, OBC1.38 (ADC2)
unnamed: J8.39, J8.40, OBC1.40 (ADC3)
unnamed: U6.3 (~WDO), U6.4 (~MR)

Notes on the sheet:
Exterior (rightmost) connector - pins 53 to 104
Interior (leftmost) connector - pins 1 to 52
All unused pins are pulled to ground through pull down resistors. Adjacent pins are connected together.
Pulldown resistors
STLink V2 programming header
Boot selection through jumper
RTC
Thermometers
256kB EEPROM in socket
Watchdog Timer
I2C pullups
Barometer

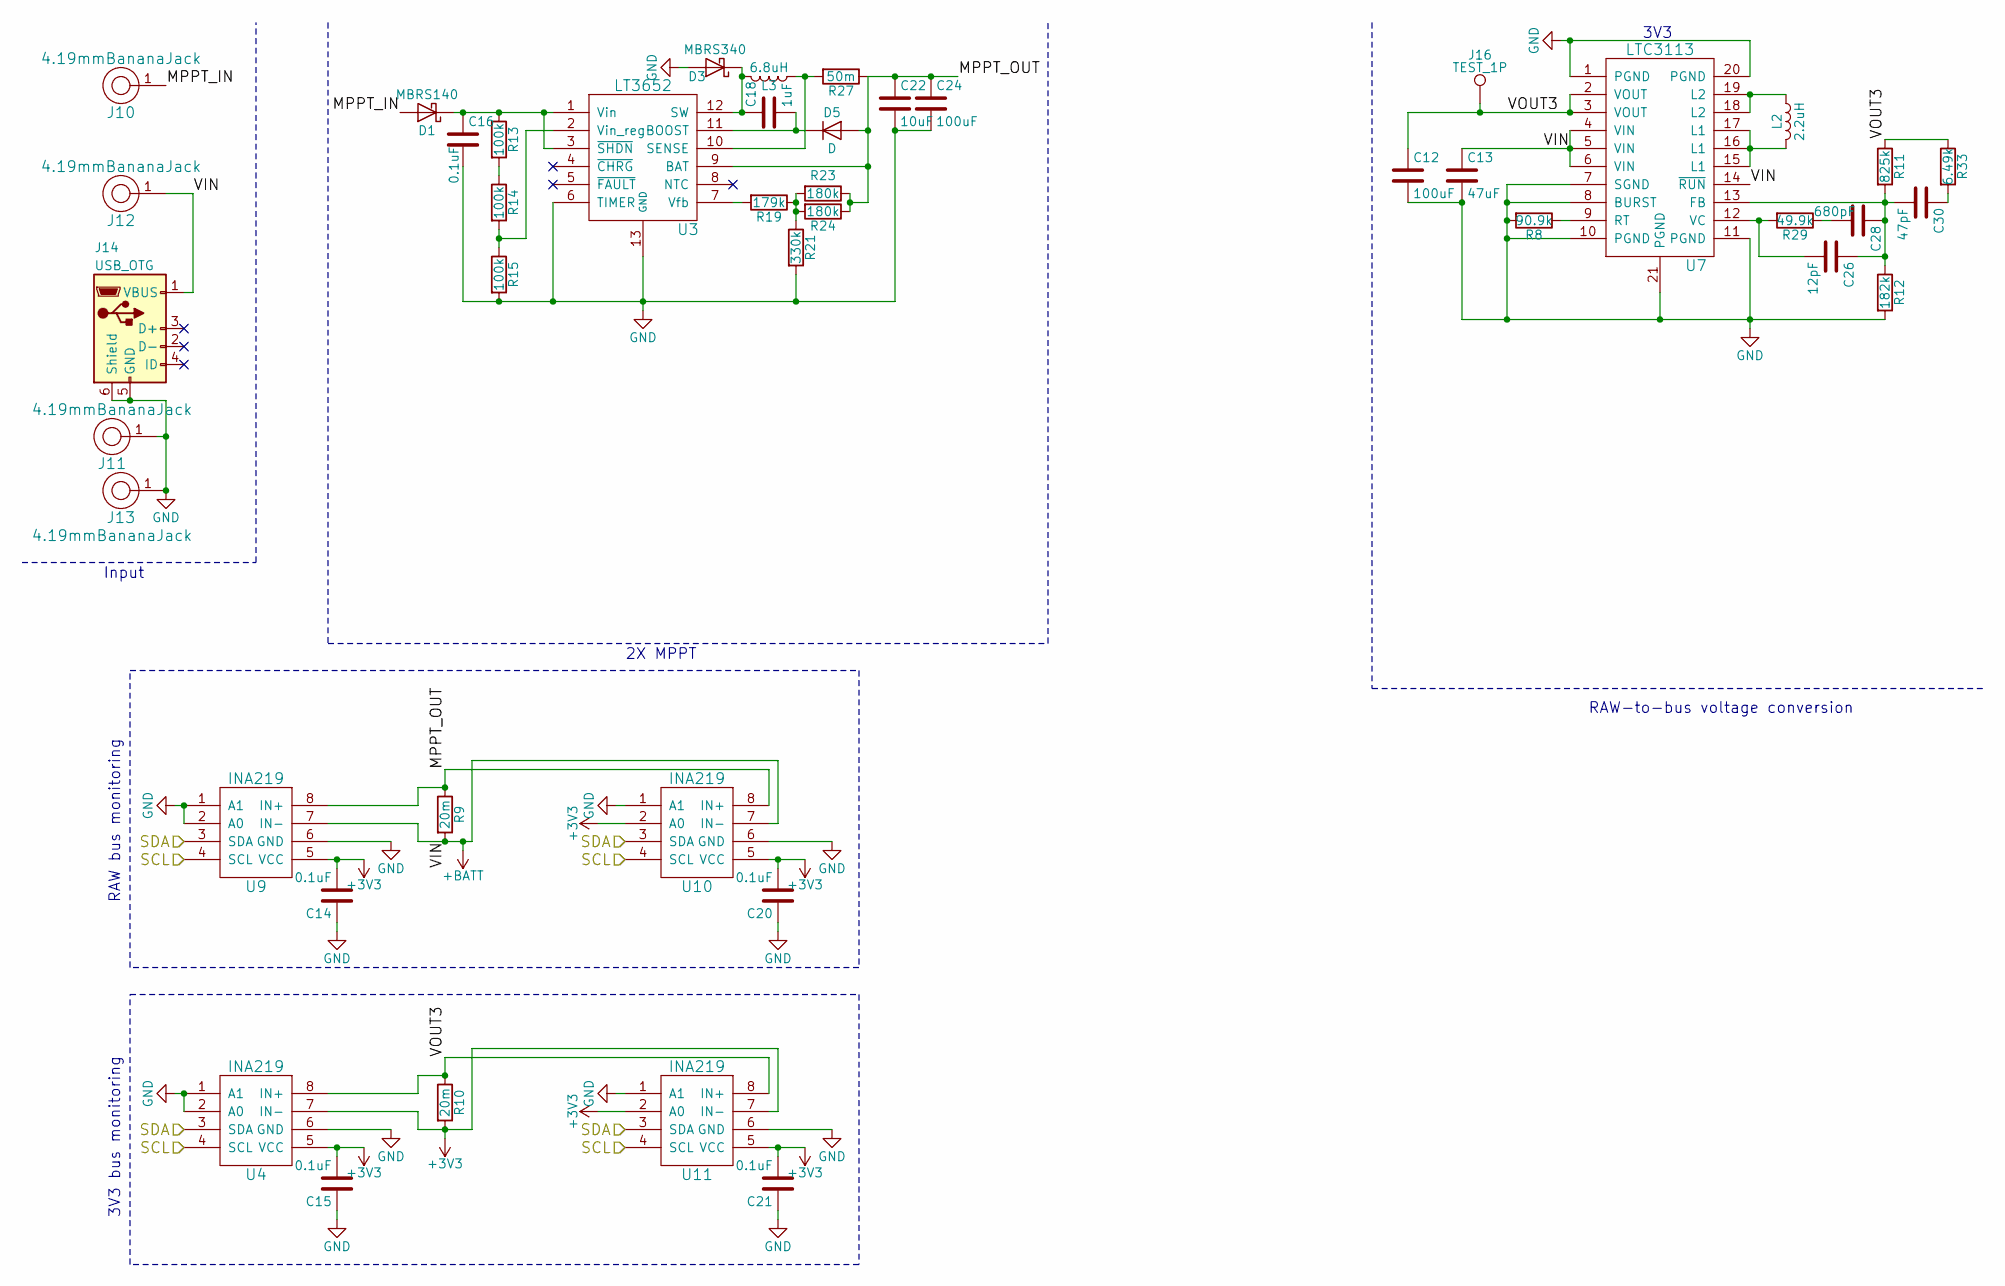
[picture p19: schematic power.sch, ARIETTA TEST BOARD]

Parts:
C12, C24: 100uF; C_0805_HandSoldering
C13: 47uF; C_0805_HandSoldering
C14, C15, C16, C20, C21: 0.1uF; C_0805_HandSoldering
C18: 1uF; C_0805_HandSoldering
C22: 10uF; C_0805_HandSoldering
C26: 12pF; C_0805_HandSoldering
C28: 680pF; C_0805_HandSoldering
C30: 47pF; C_0805_HandSoldering
D1: MBRS140; D_SMB
D3: MBRS340; D_SMC
D5: D; SOD-123FL
J10, J11, J12, J13: 4.19mmBananaJack; 4.19Banana
J14: USB_OTG; micro_usb_smd
J16: TEST_1P; Measurement_Point_Round-SMD-Pad_Big
L2: 2.2uH; L-7443330220
L3: 6.8uH; L-SLF6028T-6R8M1R5-PF
R8: 90.9k; R_0805_HandSoldering
R9, R10: 20m; R_1206_HandSoldering
R11: 825k; R_0805_HandSoldering
R12: 182k; R_0805_HandSoldering
R13, R14, R15: 100k; R_0805_HandSoldering
R19: 179k; R_0805_HandSoldering
R21: 330k; R_0805_HandSoldering
R23, R24: 180k; R_0805_HandSoldering
R27: 50m; R_1206_HandSoldering
R29: 49.9k; R_0805_HandSoldering
R33: 6.49k; R_0805_HandSoldering
U3: LT3652; 12MSOP-E
U4, U9, U10, U11: INA219; SOIC-8_3.9x4.9mm_Pitch1.27mm
U7: LTC3113; 20TSSOP-E

Connections:
+3V3: C14.2, C15.2, C20.2, C21.2, R10.2, U4.5 (VCC), U4.7 (IN-), U9.5 (VCC), U10.2 (A0), U10.5 (VCC), U11.2 (A0), U11.5 (VCC), U11.7 (IN-); also elsewhere on the board
+BATT: C13.1, J12.1, J14.1 (VBUS), R9.2, U7.4 (VIN), U7.5 (VIN), U7.6 (VIN), U7.14 (~RUN), U9.7 (IN-), U10.7 (IN-); also elsewhere on the board
/POWER/MPPT_IN: D1.2 (A), J10.1
/POWER/MPPT_OUT: C22.1, C24.1, D5.2 (A), R9.1, R23.1, R24.1, R27.1, U3.9 (BAT), U9.8 (IN+), U10.8 (IN+)
/POWER/VOUT3: C12.1, J16.1, R10.1, R11.1, R33.1, U4.8 (IN+), U7.2 (VOUT), U7.3 (VOUT), U11.8 (IN+)
/SCL0: U4.4 (SCL), U9.4 (SCL), U10.4 (SCL), U11.4 (SCL); also elsewhere on the board
/SDA0: U4.3 (SDA), U9.3 (SDA), U10.3 (SDA), U11.3 (SDA); also elsewhere on the board
GND: C12.2, C13.2, C14.1, C15.1, C16.2, C20.1, C21.1, C22.2, C24.2, D3.2 (A), J11.1, J13.1, J14.5 (GND), J14.6 (Shield), R8.2, R12.2, R15.2, R21.2, U3.6 (TIMER), U3.13 (GND), U4.1 (A1), U4.2 (A0), U4.6 (GND), U7.1 (PGND), U7.7 (SGND), U7.8 (BURST), U7.10 (PGND), U7.11 (PGND), U7.20 (PGND), U7.21 (PGND), U9.1 (A1), U9.2 (A0), U9.6 (GND), U10.1 (A1), U10.6 (GND), U11.1 (A1), U11.6 (GND); also elsewhere on the board
unnamed: C16.1, D1.1 (K), R13.1, U3.1 (Vin), U3.3 (~SHDN)
unnamed: C18.1, D3.1 (K), L3.2, U3.12 (SW)
unnamed: C18.2, D5.1 (K), U3.11 (BOOST)
unnamed: C26.1, C28.1, C30.2, R11.2, R12.1, U7.13 (FB)
unnamed: C26.2, R29.2, U7.12 (VC)
unnamed: C28.2, R29.1
unnamed: C30.1, R33.2
unnamed: L2.1, U7.18 (L2), U7.19 (L2)
unnamed: L2.2, U7.15 (L1), U7.16 (L1), U7.17 (L1)
unnamed: L3.1, R27.2, U3.10 (SENSE)
unnamed: R8.1, U7.9 (RT)
unnamed: R13.2, R14.1
unnamed: R14.2, R15.1, U3.2 (Vin_reg)
unnamed: R19.1, R21.1, R23.2, R24.2
unnamed: R19.2, U3.7 (Vfb)

Notes on the sheet:
3V3
Input
2X MPPT
RAW-to-bus voltage conversion
RAW bus monitoring
3V3 bus monitoring

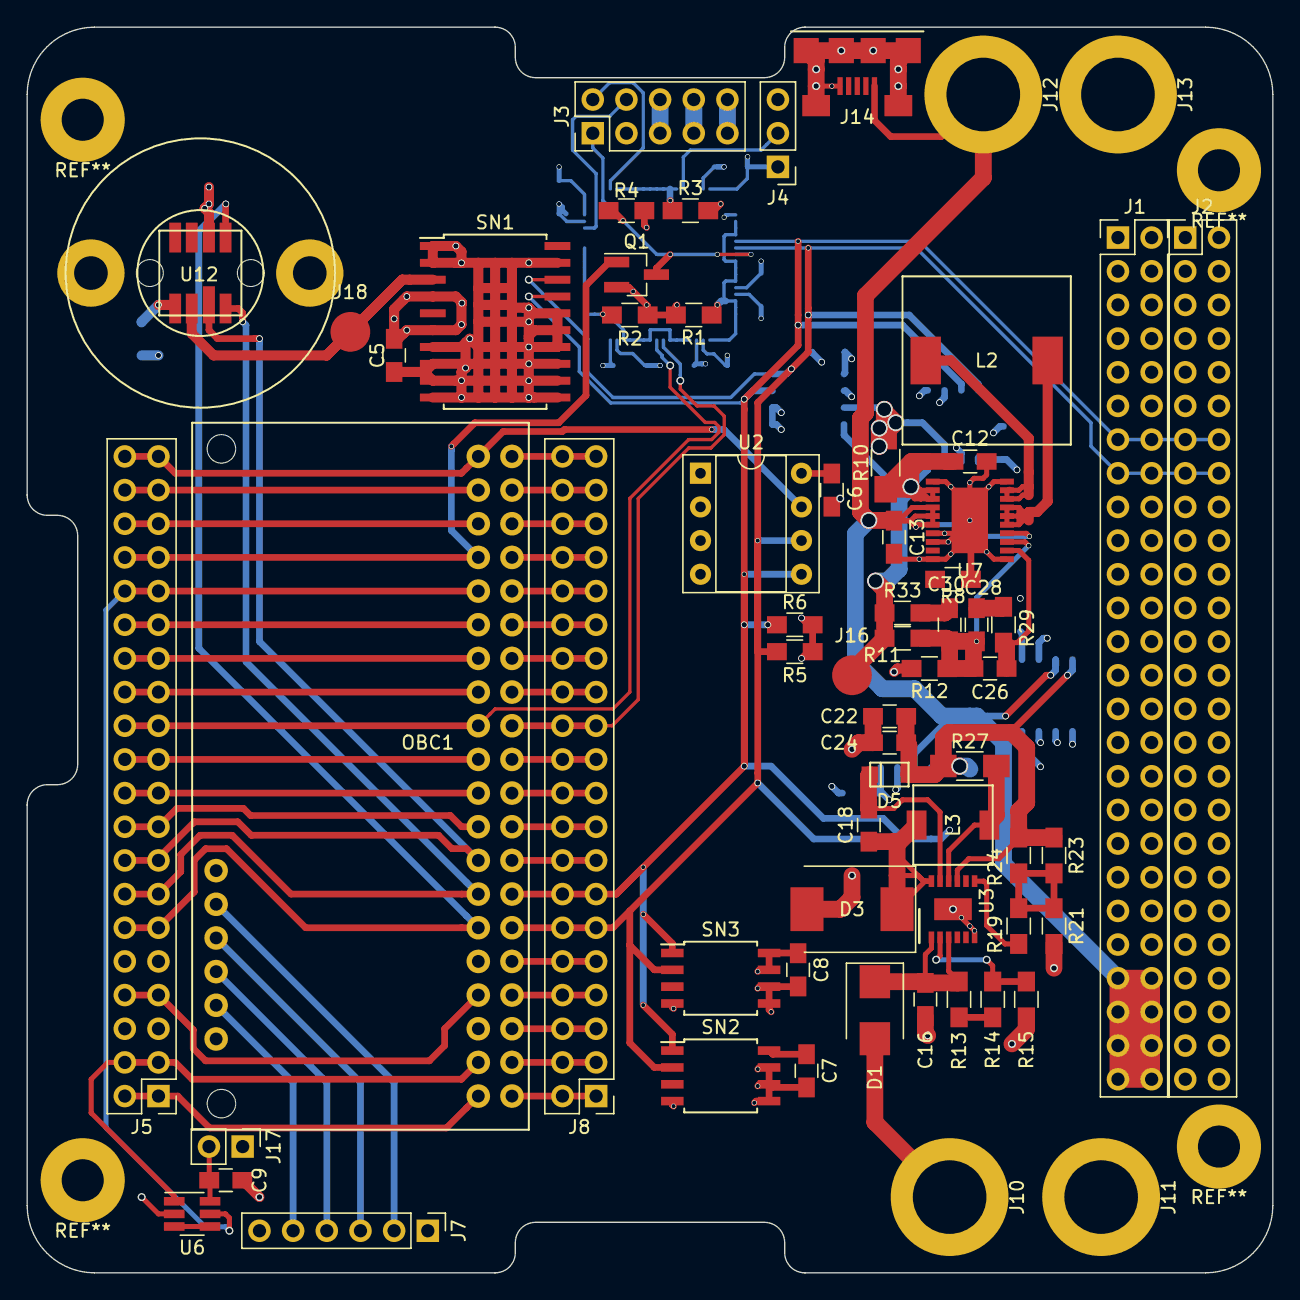
[picture p20: board Test_board.kicad_pcb from above]

Board: 4 copper layers, 94.0 x 94.0 mm, 80 parts (0 on the bottom side), 74 nets.
