Space-Fernie/system_test_board/(commit log)

2017-09-18 Initial push, adding hardware and preliminary software
    [3dprintmodel.STL, Test Board Spreadsheets.xlsx, bracket.SLDASM, bracket_half_bottom.SLDASM, bracket_half_bottom.SLDPRT, bracket_half_top.SLDASM, cell.SLDPRT, clamp.SLDPRT]
2017-09-18 Found missing software files from first commit
    [main.cpp]
2017-09-22 Deleted PCB files, removed MCUs and 1 USB port from schematic, cleaned up schematic
    [test_board.kicad_pcb, test_board.sch, test_board[Conflict 1] (1).kicad_pcb, test_board[Conflict 1].kicad_pcb, test_board[Conflict] (1).kicad_pcb, test_board[Conflict].kicad_pcb]
2017-09-30 Started defining STM32F303RE component
    [test_board.sch]
2017-10-04 Updated schematic around MCU, defined comms pinout. Started setup of CAN bus connectors.
    [test_board.sch]
2017-10-10 Replaced TPS63000 with new IC and started wiring it. Started migrating previous libraries to new global Aleksandr library.
    [power_schematic.sch, sensors_schematic.sch, test_board.sch]
2017-10-14 Added component to library, fixed ground line for 3V3 converter.
    [power_schematic.sch]
2017-10-18 Added programming header to diagram. Changed drafting template
    [power_schematic.sch, sensors_schematic.sch, test_board.sch]
2017-11-02 Started V2.1, used template, found new programmable buck-boost converter
    [Test_board.kicad_pcb, interfacing_schem.sch, power.sch, power_schematic.sch, sensors_schematic (1).sch, sensors_schematic.sch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]
2017-11-03 Added temp, rtc, and mcu connections
    [test_board.sch]
2017-11-03 Wired the whole first sheet
    [power.sch, test_board.sch]
2017-11-04 Wired most of power converters, only VC pins to wire
    [power.sch]
2017-11-07 Finished schematic
    [power.sch, test_board.sch]
2017-11-08 Updated libraries, footprint assignments, and created protector for barometer
    [Barometer chamber.SLDDRW, Barometer chamber.SLDPRT, power.sch, test_board.sch]
2017-11-09 Removed db9, created last footprints, finished assigning footprints, started pcb
    [Test_board.kicad_pcb, power.sch, test_board.sch]
2017-11-10 finished pcb
    [Test_board-B.Mask.gbr, Test_board-B.SilkS.gbr, Test_board-BOT.gbr, Test_board-Edge.Cuts.gbr, Test_board-F.Mask.gbr, Test_board-F.SilkS.gbr, Test_board-GND.gbr, Test_board-NPTH.drl]
2017-11-16 mainly work on the barometer chamber
    [Barometer chamber.SLDDRW, Test_board.csv, assembly.SLDASM, test_board model.SLDPRT, test_board model.wrl.sldprt, test_boardBOM.csv]
2017-11-23 Branched out for V3, started BBB cape for remote device
    [BBB cape.kicad_pcb, BBB cape.sch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]
2017-11-24 Finished adding components and mapping connections for BBB cape
    [BBB cape.sch]
2017-11-24 Assigned some components
    [BBB cape.sch]
2017-12-14 Created step model of test board to try KiCad StepUp
    [Test_board.FCStd]
